Hardware7253/Koca58/README.md

# Lily58 Koca

A [Lily58](https://github.com/kata0510/Lily58) variant featuring SMT components, RJ45 interconnect and STM32F103 MCU.

## Pictures
Keyboard
Right Keyboard
Electronics Window
Connectors
