Hardware7253/Koca58/Case/Old/README.md

These are the old case files for the TRRS version of this design
