Hardware7253/Koca58/Case/Assembly.step

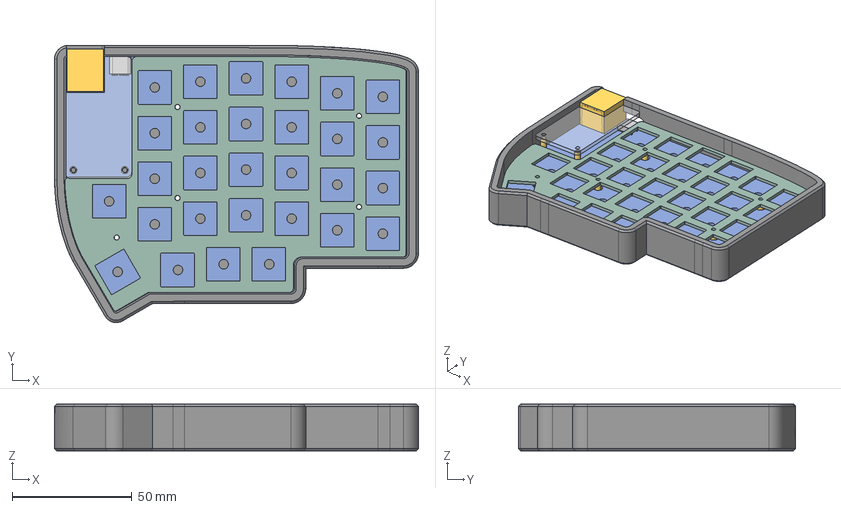
[picture p1: CAD file, 2025-12-16]
Case/Assembly.step
152.0 x 115.7 x 19.6 mm
Plate_PCB
Mount Standoff x 5
Assembly PCB
Right Case
Acrylic Standoff x 2
HRO TYPE-C-31-M-12
Acrylic Piece
54602-908LFc
