Hardware7253/Koca58/Case/Right Case.stl

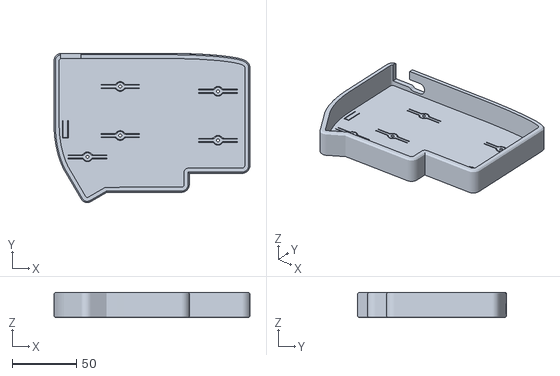
[picture p2: CAD file, 2025-12-16]
Case/Right Case.stl
152.0 x 115.7 x 19.6
