Hardware7253/Koca58/PCB/Koca.step

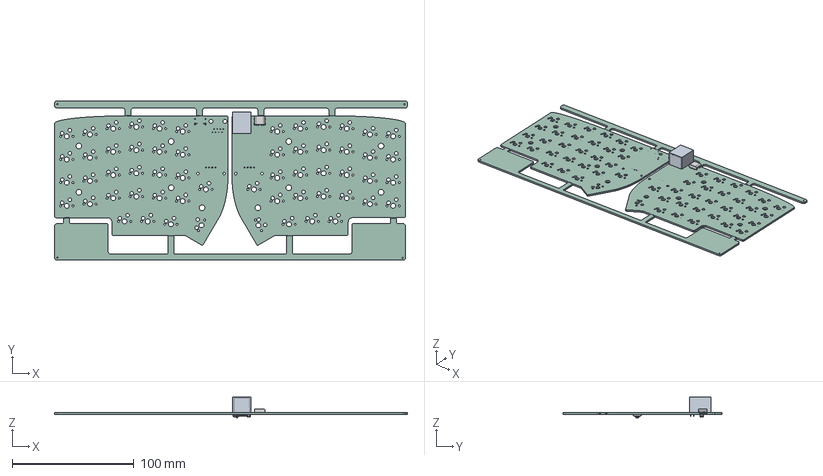
[picture p3: CAD file, 2025-05-18]
PCB/Koca.step
290.1 x 131.0 x 16.9 mm
54602-908LFc
HRO TYPE-C-31-M-12
SW_SPST_CK_RS282G05A3
Koca58_PCB
