Hardware7253/Koca58/Case/Old/Old Case.step

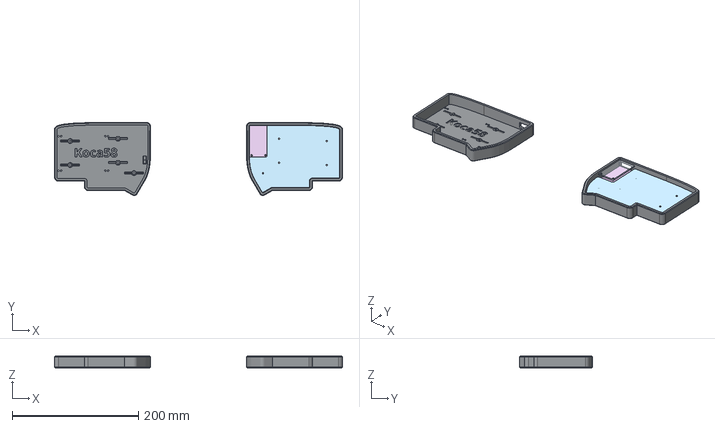
[picture p4: CAD file, 2025-05-18, an earlier design]
Case/Old/Old Case.step
456.3 x 115.7 x 18.6 mm
