Hardware7253/Koca58/(list of files, cad)

Other CAD files:
Case/Left Case.stl
