Hardware7253/Koca58/PCB/Koca58.kicad_pcb

## KiCad design PCB/Koca58.kicad_pcb (2026-08-27)

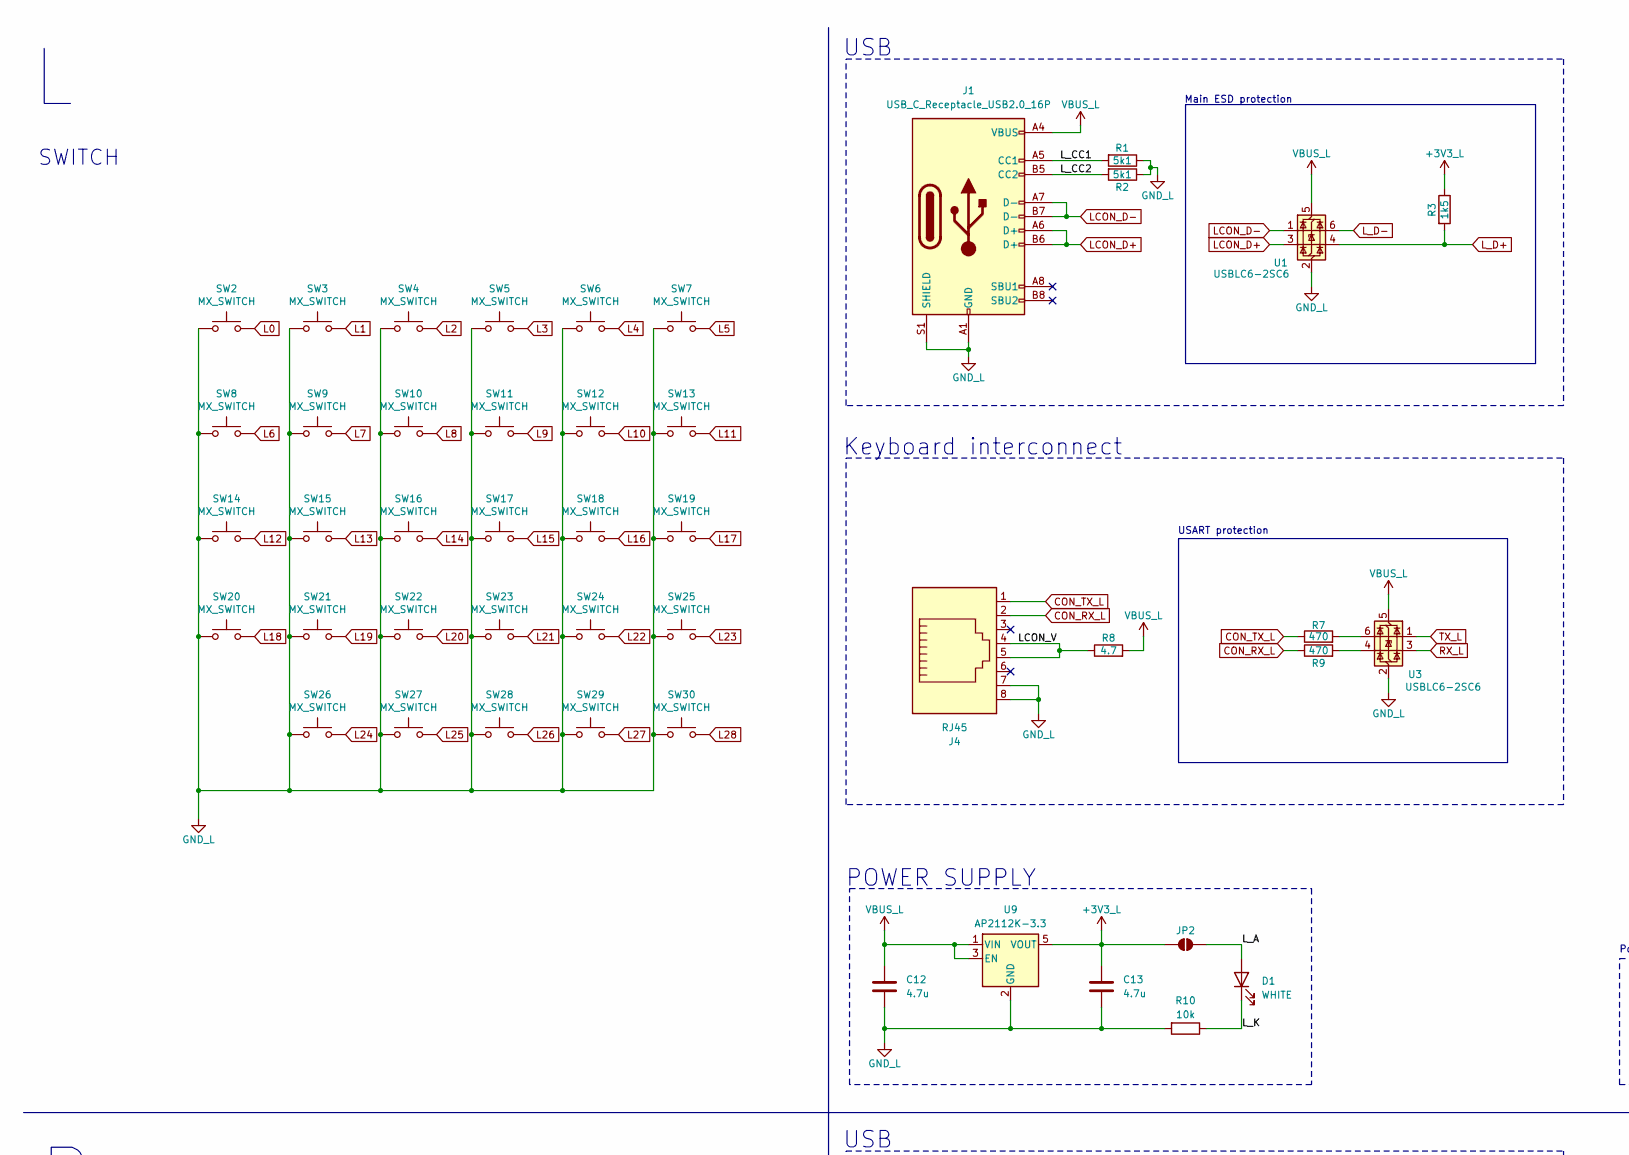
[picture p5: schematic Koca58.kicad_sch, part in row 1, column 1]

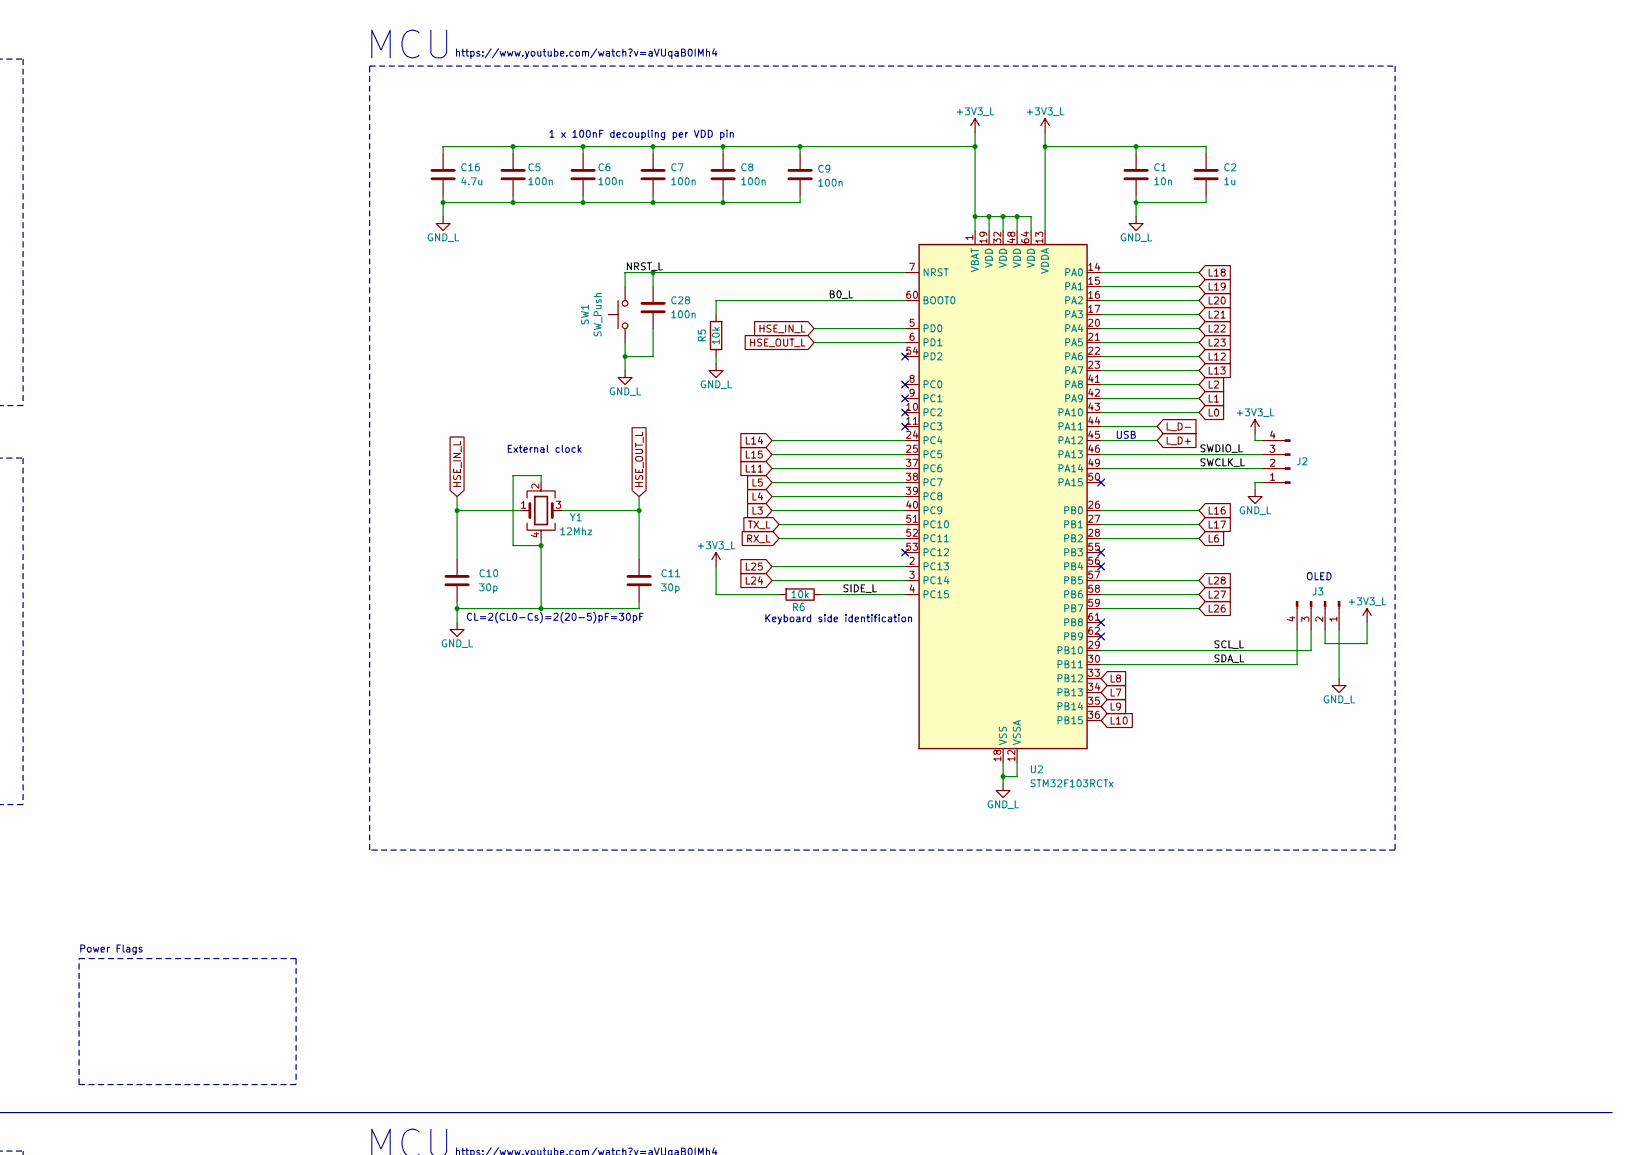
[picture p6: schematic Koca58.kicad_sch, part in row 1, column 2]

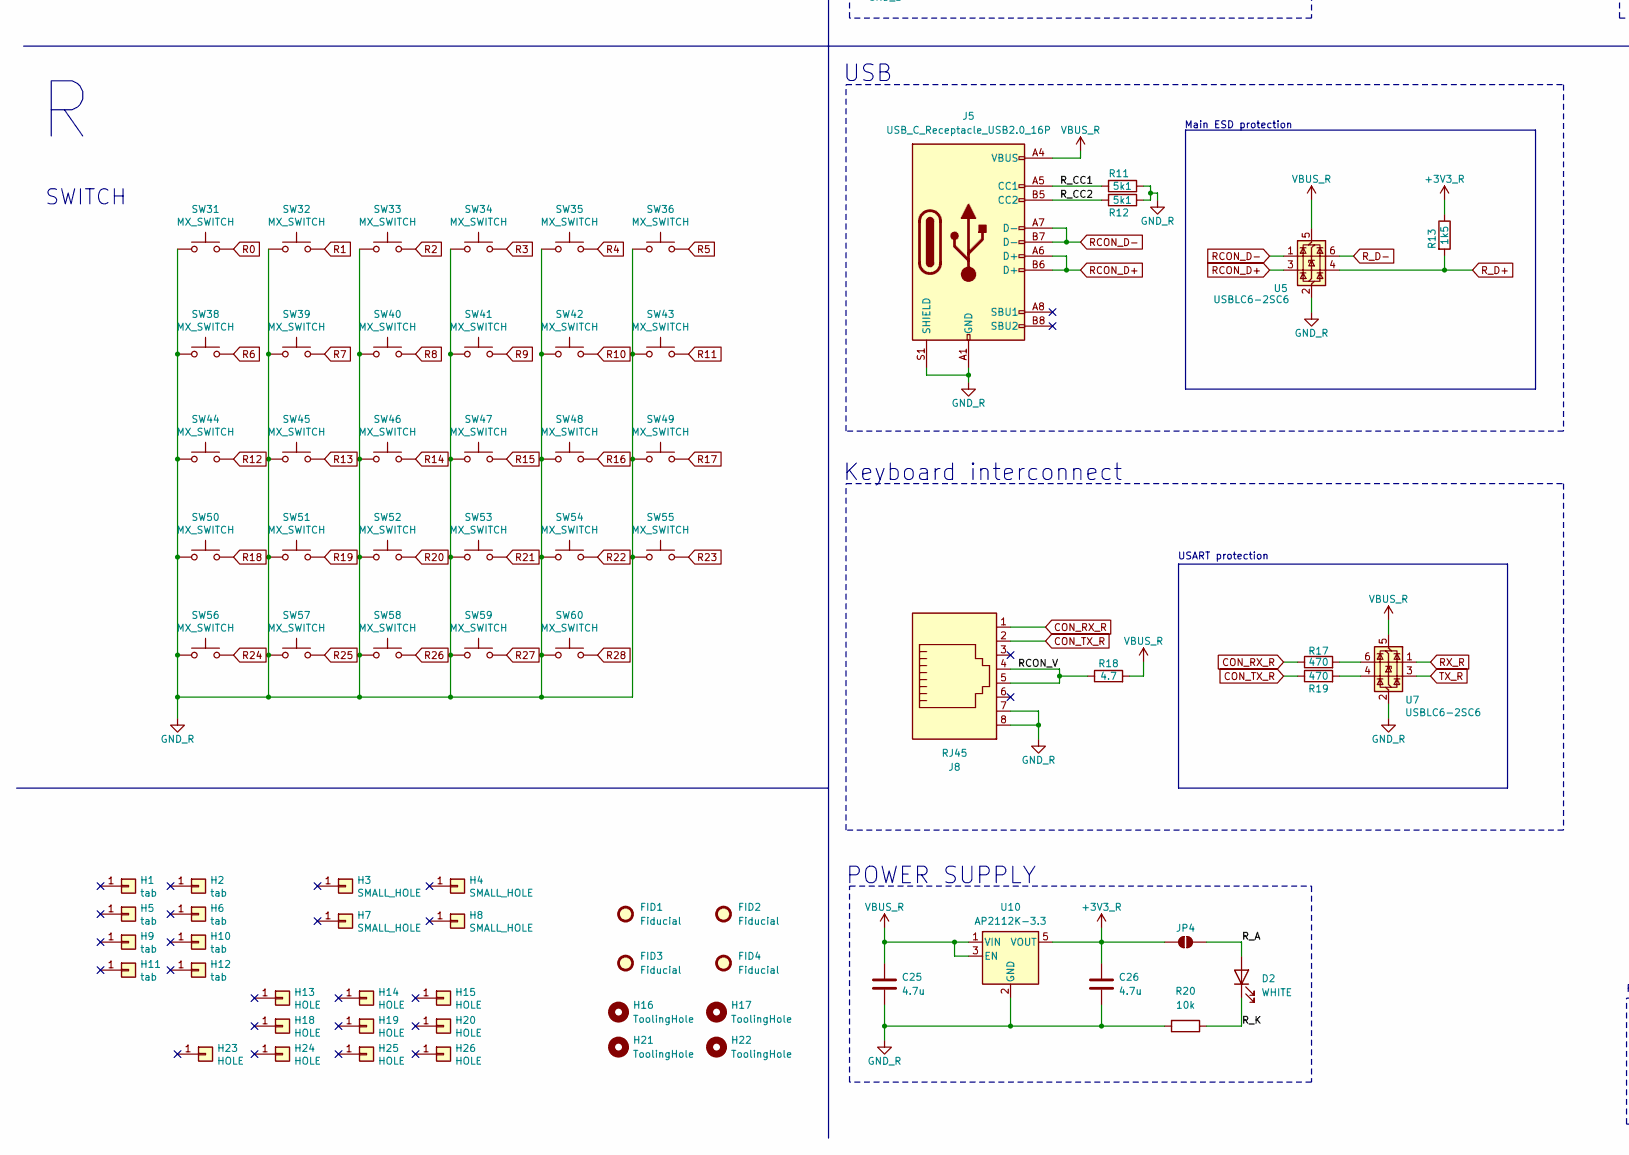
[picture p7: schematic Koca58.kicad_sch, part in row 2, column 1]

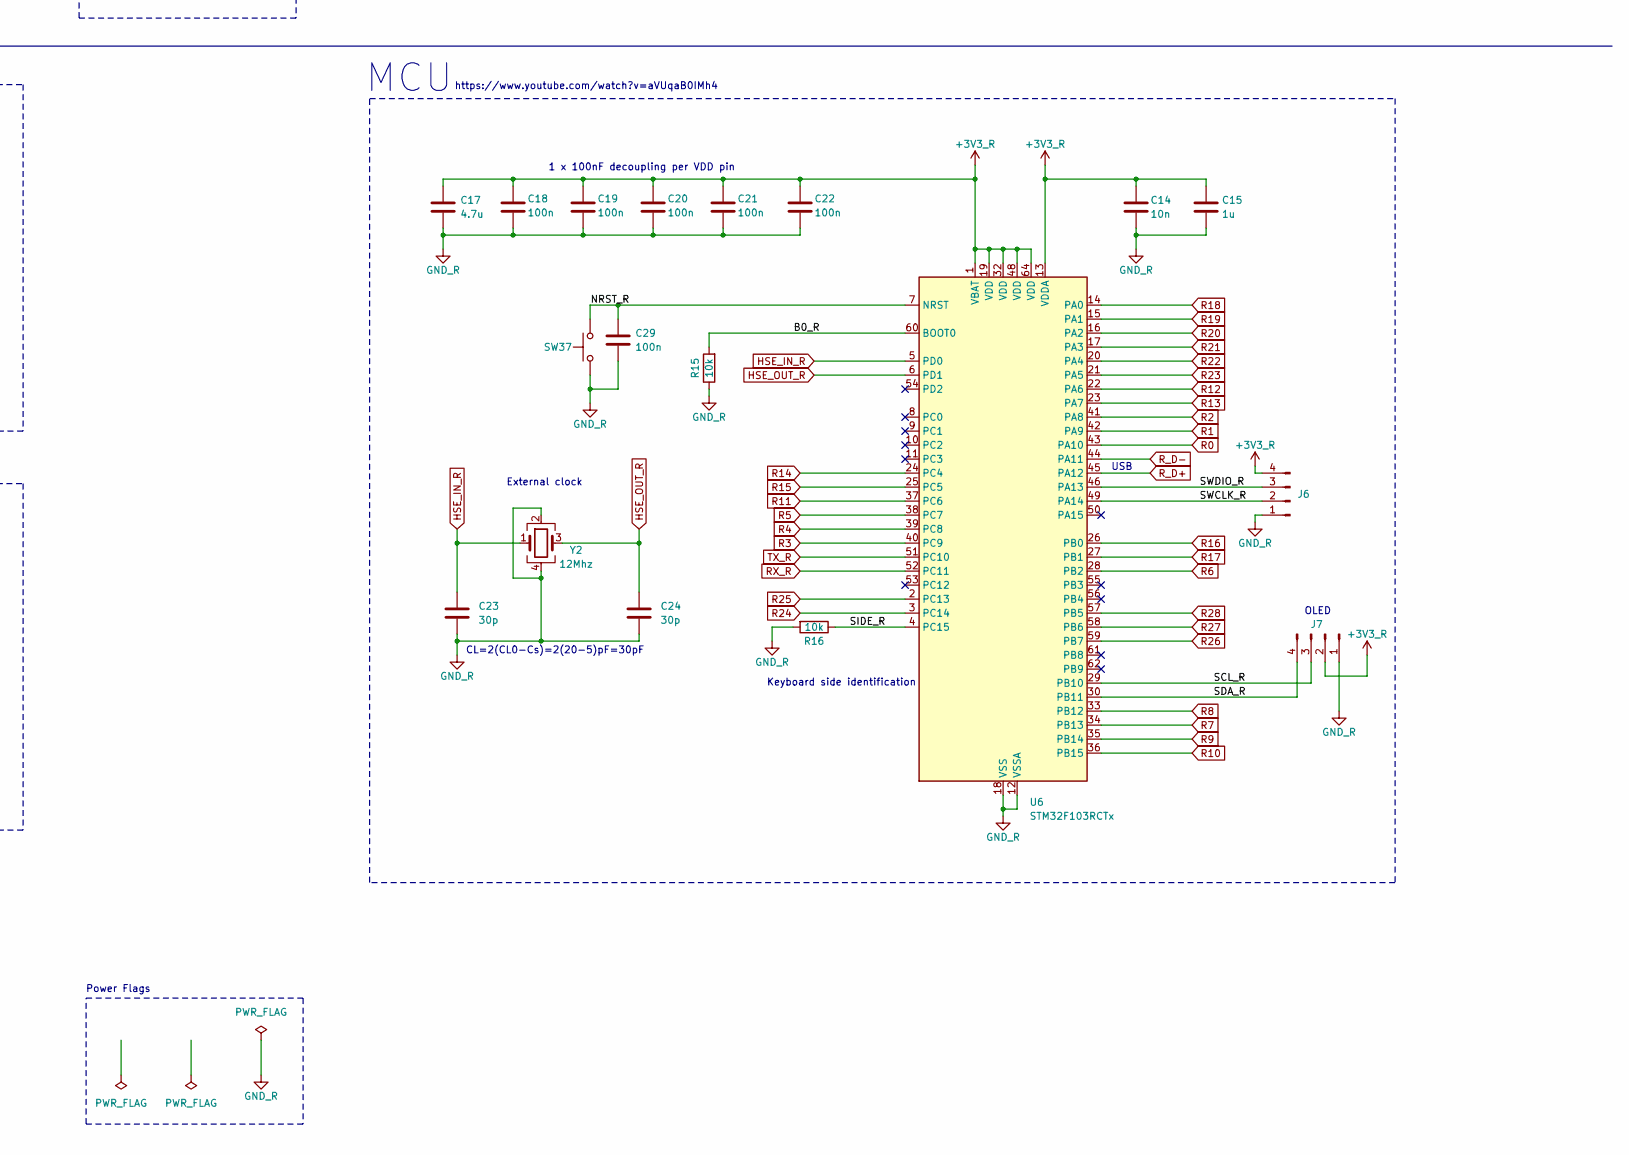
[picture p8: schematic Koca58.kicad_sch, part in row 2, column 2]

Parts:
C1, C14: 10n; C_0402_1005Metric; Manufacturer Part Number CL05B103KB5NNNC; LCSC/JLC Part Number C15195
C2, C15: 1u; C_0402_1005Metric; Manufacturer Part Number CL05A105KA5NQNC; LCSC/JLC Part Number C52923
C5, C6, C7, C8, C9, C18, C19, C20, C21, C22, C28, C29: 100n; C_0402_1005Metric; Manufacturer Part Number CL05B104KO5NNNC; LCSC/JLC Part Number C1525
C10, C11, C23, C24: 30p; C_0402_1005Metric; Manufacturer Part Number 0402CG330J500NT; LCSC/JLC Part Number C1562
C12, C13, C16, C17, C25, C26: 4.7u; C_0603_1608Metric; Manufacturer Part Number CL10A475KO8NNNC; LCSC/JLC Part Number C19666
D1, D2: WHITE; LED_0603_1608Metric; Manufacturer Part Number KT-0603W; LCSC/JLC Part Number C2290
FID1, FID2, FID3, FID4: Fiducial; Fiducial_1mm_Mask2mm
H1, H2, H5, H6, H9, H10, H11, H12: tab; MouseBite
H3, H4, H7, H8: SMALL_HOLE; MountingHole_2.2mm_M2_Pad
H13, H14, H15, H18, H19, H20, H23, H24, H25, H26: HOLE; Standoff_Hole
H16, H17, H21, H22: ToolingHole; SMD_Tooling_Hole
J1, J5: USB_C_Receptacle_USB2.0_16P; USB_TYPE-C-31-M-12; Manufacturer Part Number TYPE-C-31-M-12; LCSC/JLC Part Number C165948
J2, J6: Conn_01x04_Pin; SWD_POGO_P1.27
J3, J7: Conn_01x04_Pin; PinHeader_1x04_P2.54mm_Vertical
J4, J8: RJ45; RJ45_Amphenol_54602-x08_Horizontal; Manufacturer Part Number 54602-908LF; LCSC/JLC Part Number C2847314
JP2, JP4: SolderJumper_2_Open; SolderJumper-2_P1.3mm_Bridged_Pad1.0x1.5mm
R1, R2, R11, R12: 5k1; R_0402_1005Metric; Manufacturer Part Number 0402WGF5101TCE; LCSC/JLC Part Number C25905
R3, R13: 1k5; R_0402_1005Metric; Manufacturer Part Number 0402WGF1501TCE; LCSC/JLC Part Number C25867
R5, R6, R10, R15, R16, R20: 10k; R_0402_1005Metric; Manufacturer Part Number 0402WGF1002TCE; LCSC/JLC Part Number C25744
R7, R9, R17, R19: 470; R_0402_1005Metric; Manufacturer Part Number 0402WGF4700TCE; LCSC/JLC Part Number C25117
R8, R18: 4.7; R_0603_1608Metric; Manufacturer Part Number 0603WAF470KT5E; LCSC/JLC Part Number C23164
SW1, SW37: SW_Push; Korean Hroparts Elec K2-1107ST-A4DW-06; Manufacturer Part Number K2-1107ST-A4DW-06; LCSC/JLC Part Number C118141
SW2, SW3, SW4, SW5, SW6, SW7, SW8, SW9, SW10, SW11, SW12, SW13, SW14, SW15, SW16, SW17, SW18, SW19, SW20, SW21, SW22, SW23, SW24, SW25, SW26, SW27, SW28, SW29, SW30, SW31, SW32, SW33, SW34, SW35, SW36, SW38, SW39, SW40, SW41, SW42, SW43, SW44, SW45, SW46, SW47, SW48, SW49, SW50, SW51, SW52, SW53, SW54, SW55, SW56, SW57, SW58, SW59, SW60: MX_SWITCH; MX_Hotswap; Manufacturer Part Number CPG151101S11-16; LCSC/JLC Part Number C41430893
U1, U3, U5, U7: USBLC6-2SC6; SOT-23-6; Manufacturer Part Number USBLC6-2SC6; LCSC/JLC Part Number C2687116
U2, U6: STM32F103RCTx; LQFP-64_10x10mm_P0.5mm; Manufacturer Part Number STM32F103RCT6; LCSC/JLC Part Number C8323
U9, U10: AP2112K-3.3; SOT-23-5; Manufacturer Part Number AP2112K-3.3TRG1; LCSC/JLC Part Number C51118
Y1, Y2: 12Mhz; Crystal_SMD_3225-4Pin_3.2x2.5mm; Manufacturer Part Number X322512MSB4SI; LCSC/JLC Part Number C9002

Connections:
+3V3_L: C1.1, C2.1, C5.1, C6.1, C7.1, C8.1, C9.1, C13.1, C16.1, J2.4, J3.2, JP2.1 (A), R3.1, R6.2, U2.1 (VBAT), U2.13 (VDDA), U2.19 (VDD), U2.32 (VDD), U2.48 (VDD), U2.64 (VDD), U9.5 (VOUT)
+3V3_R: C14.1, C15.1, C17.1, C18.1, C19.1, C20.1, C21.1, C22.1, C26.1, J6.4, J7.2, JP4.1 (A), R13.1, U6.1 (VBAT), U6.13 (VDDA), U6.19 (VDD), U6.32 (VDD), U6.48 (VDD), U6.64 (VDD), U10.5 (VOUT)
/B0_L: R5.2, U2.60 (BOOT0)
/B0_R: R15.2, U6.60 (BOOT0)
/LCON_V: J4.4, J4.5, R8.1
/L_A: D1.2 (A), JP2.2 (B)
/L_CC1: J1.A5 (CC1), R1.2
/L_CC2: J1.B5 (CC2), R2.2
/L_K: D1.1 (K), R10.1
/NRST_L: C28.1, SW1.2, U2.7 (NRST)
/NRST_R: C29.1, SW37.2, U6.7 (NRST)
/RCON_V: J8.4, J8.5, R18.1
/R_A: D2.2 (A), JP4.2 (B)
/R_CC1: J5.A5 (CC1), R11.2
/R_CC2: J5.B5 (CC2), R12.2
/R_K: D2.1 (K), R20.1
/SCL_L: J3.3, U2.29 (PB10)
/SCL_R: J7.3, U6.29 (PB10)
/SDA_L: J3.4, U2.30 (PB11)
/SDA_R: J7.4, U6.30 (PB11)
/SIDE_L: R6.1, U2.4 (PC15)
/SIDE_R: R16.1, U6.4 (PC15)
/SWCLK_L: J2.2, U2.49 (PA14)
/SWCLK_R: J6.2, U6.49 (PA14)
/SWDIO_L: J2.3, U2.46 (PA13)
/SWDIO_R: J6.3, U6.46 (PA13)
CON_RX_L: J4.2, R9.1
CON_RX_R: J8.1, R17.1
CON_TX_L: J4.1, R7.1
CON_TX_R: J8.2, R19.1
GND_L: C1.2, C2.2, C5.2, C6.2, C7.2, C8.2, C9.2, C10.2, C11.2, C12.2, C13.2, C16.2, C28.2, J1.A1 (GND), J1.A12 (GND), J1.B1 (GND), J1.B12 (GND), J1.S1 (SHIELD), J2.1, J3.1, J4.7, J4.8, R1.1, R2.1, R5.1, R10.2, SW1.1, SW2.1, SW3.1, SW4.1, SW5.1, SW6.1, SW7.1, SW8.1, SW9.1, SW10.1, SW11.1, SW12.1, SW13.1, SW14.1, SW15.1, SW16.1, SW17.1, SW18.1, SW19.1, SW20.1, SW21.1, SW22.1, SW23.1, SW24.1, SW25.1, SW26.1, SW27.1, SW28.1, SW29.1, SW30.1, U1.2 (GND), U2.12 (VSSA), U2.18 (VSS), U2.31 (VSS), U2.47 (VSS), U2.63 (VSS), U3.2 (GND), U9.2 (GND), Y1.2, Y1.4
GND_R: C14.2, C15.2, C17.2, C18.2, C19.2, C20.2, C21.2, C22.2, C23.2, C24.2, C25.2, C26.2, C29.2, J5.A1 (GND), J5.A12 (GND), J5.B1 (GND), J5.B12 (GND), J5.S1 (SHIELD), J6.1, J7.1, J8.7, J8.8, R11.1, R12.1, R15.1, R16.2, R20.2, SW31.1, SW32.1, SW33.1, SW34.1, SW35.1, SW36.1, SW37.1, SW38.1, SW39.1, SW40.1, SW41.1, SW42.1, SW43.1, SW44.1, SW45.1, SW46.1, SW47.1, SW48.1, SW49.1, SW50.1, SW51.1, SW52.1, SW53.1, SW54.1, SW55.1, SW56.1, SW57.1, SW58.1, SW59.1, SW60.1, U5.2 (GND), U6.12 (VSSA), U6.18 (VSS), U6.31 (VSS), U6.47 (VSS), U6.63 (VSS), U7.2 (GND), U10.2 (GND), Y2.2, Y2.4
HSE_IN_L: C10.1, U2.5 (PD0), Y1.1
HSE_IN_R: C23.1, U6.5 (PD0), Y2.1
HSE_OUT_L: C11.1, U2.6 (PD1), Y1.3
HSE_OUT_R: C24.1, U6.6 (PD1), Y2.3
L0: SW2.2, U2.43 (PA10)
L1: SW3.2, U2.42 (PA9)
L2: SW4.2, U2.41 (PA8)
L3: SW5.2, U2.40 (PC9)
L4: SW6.2, U2.39 (PC8)
L5: SW7.2, U2.38 (PC7)
L6: SW8.2, U2.28 (PB2)
L7: SW9.2, U2.34 (PB13)
L8: SW10.2, U2.33 (PB12)
L9: SW11.2, U2.35 (PB14)
L10: SW12.2, U2.36 (PB15)
L11: SW13.2, U2.37 (PC6)
L12: SW14.2, U2.22 (PA6)
L13: SW15.2, U2.23 (PA7)
L14: SW16.2, U2.24 (PC4)
L15: SW17.2, U2.25 (PC5)
L16: SW18.2, U2.26 (PB0)
L17: SW19.2, U2.27 (PB1)
L18: SW20.2, U2.14 (PA0)
L19: SW21.2, U2.15 (PA1)
L20: SW22.2, U2.16 (PA2)
L21: SW23.2, U2.17 (PA3)
L22: SW24.2, U2.20 (PA4)
L23: SW25.2, U2.21 (PA5)
L24: SW26.2, U2.3 (PC14)
L25: SW27.2, U2.2 (PC13)
L26: SW28.2, U2.59 (PB7)
L27: SW29.2, U2.58 (PB6)
L28: SW30.2, U2.57 (PB5)
LCON_D+: J1.A6 (D+), J1.B6 (D+), U1.3 (I/O2)
LCON_D-: J1.A7 (D-), J1.B7 (D-), U1.1 (I/O1)
L_D+: R3.2, U1.4 (I/O2), U2.45 (PA12)
L_D-: U1.6 (I/O1), U2.44 (PA11)
unnamed: R7.2, U3.6 (I/O1)
unnamed: R9.2, U3.4 (I/O2)
unnamed: R17.2, U7.6 (I/O1)
unnamed: R19.2, U7.4 (I/O2)
R0: SW31.2, U6.43 (PA10)
R1: SW32.2, U6.42 (PA9)
R2: SW33.2, U6.41 (PA8)
R3: SW34.2, U6.40 (PC9)
R4: SW35.2, U6.39 (PC8)
R5: SW36.2, U6.38 (PC7)
R6: SW38.2, U6.28 (PB2)
R7: SW39.2, U6.34 (PB13)
R8: SW40.2, U6.33 (PB12)
R9: SW41.2, U6.35 (PB14)
R10: SW42.2, U6.36 (PB15)
R11: SW43.2, U6.37 (PC6)
R12: SW44.2, U6.22 (PA6)
R13: SW45.2, U6.23 (PA7)
R14: SW46.2, U6.24 (PC4)
R15: SW47.2, U6.25 (PC5)
R16: SW48.2, U6.26 (PB0)
R17: SW49.2, U6.27 (PB1)
R18: SW50.2, U6.14 (PA0)
R19: SW51.2, U6.15 (PA1)
R20: SW52.2, U6.16 (PA2)
R21: SW53.2, U6.17 (PA3)
R22: SW54.2, U6.20 (PA4)
R23: SW55.2, U6.21 (PA5)
R24: SW56.2, U6.3 (PC14)
R25: SW57.2, U6.2 (PC13)
R26: SW58.2, U6.59 (PB7)
R27: SW59.2, U6.58 (PB6)
R28: SW60.2, U6.57 (PB5)
RCON_D+: J5.A6 (D+), J5.B6 (D+), U5.3 (I/O2)
RCON_D-: J5.A7 (D-), J5.B7 (D-), U5.1 (I/O1)
RX_L: U2.52 (PC11), U3.3 (I/O2)
RX_R: U6.52 (PC11), U7.1 (I/O1)
R_D+: R13.2, U5.4 (I/O2), U6.45 (PA12)
R_D-: U5.6 (I/O1), U6.44 (PA11)
TX_L: U2.51 (PC10), U3.1 (I/O1)
TX_R: U6.51 (PC10), U7.3 (I/O2)
VBUS_L: C12.1, J1.A4 (VBUS), J1.A9 (VBUS), J1.B4 (VBUS), J1.B9 (VBUS), R8.2, U1.5 (VBUS), U3.5 (VBUS), U9.1 (VIN), U9.3 (EN)
VBUS_R: C25.1, J5.A4 (VBUS), J5.A9 (VBUS), J5.B4 (VBUS), J5.B9 (VBUS), R18.2, U5.5 (VBUS), U7.5 (VBUS), U10.1 (VIN), U10.3 (EN)

Notes on the sheet:
1 x 100nF decoupling per VDD pin
USART protection
Keyboard interconnect
SWITCH
USB
CL=2(CL0-Cs)=2(20-5)pF=30pF
Main ESD protection
MCU
POWER SUPPLY
https://www.youtube.com/watch?v=aVUqaB0IMh4
OLED
Keyboard side identification
External clock
Power Flags

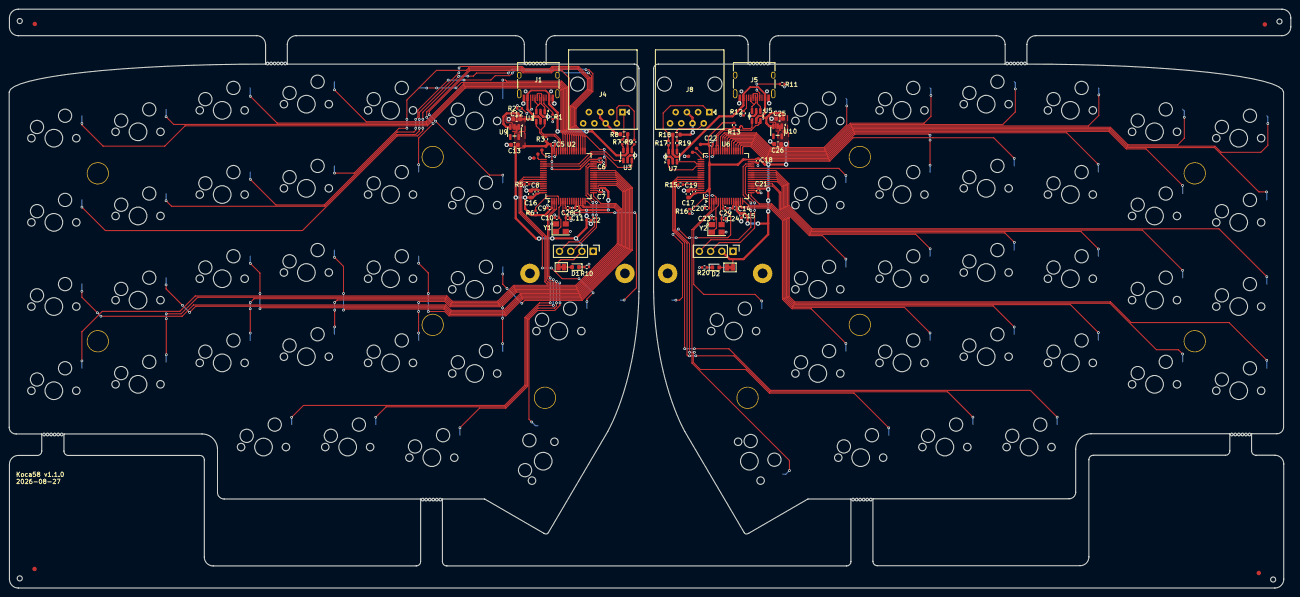
[picture p9: board Koca58.kicad_pcb from above]

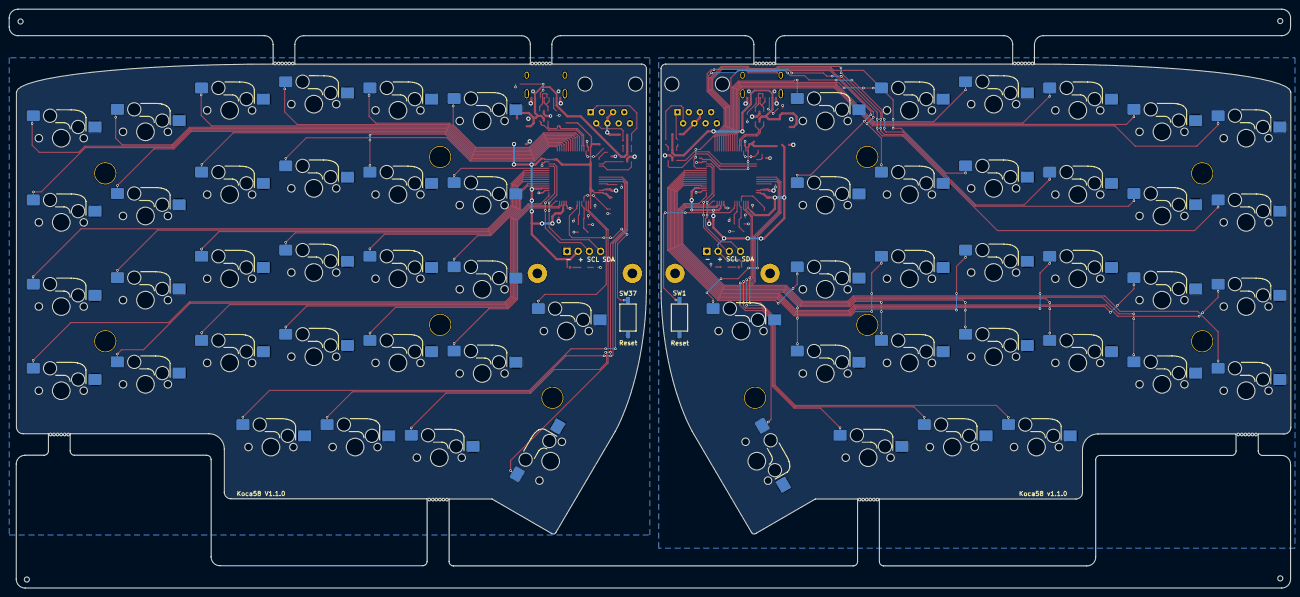
[picture p10: board Koca58.kicad_pcb from below]

Board: 2 copper layers, 290.1 x 131.0 mm, 156 parts (60 on the bottom side), 112 nets.
