Hardware7253/Koca58/(commit log)

2025-01-21 First real commit
    Add KiCad design files and bootloader binary
    [Koca-B_Cu.gbl, Koca-B_Mask.gbs, Koca-B_Paste.gbp, Koca-B_Silkscreen.gbo, Koca-Edge_Cuts.gm1, Koca-F_Cu.gtl, Koca-F_Mask.gts, Koca-F_Paste.gtp]
2025-01-29 switch to direct matrix
    [KOCA_BOM_PCBX.csv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]
2025-02-19 Prepared files for double sided PCBA
    [KOCA_BOM_PCBX.csv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]
2025-02-28 Fixed PCBx BOM
    PCBx BOM listed the wrong crystal oscillator
    [KOCA_BOM_PCBX.csv]
2025-03-07 Improve via spacing
    [KOCA_POS.csv, Koca-B_Cu.gbl, Koca-B_Mask.gbs, Koca-B_Paste.gbp, Koca-B_Silkscreen.gbo, Koca-Edge_Cuts.gm1, Koca-F_Cu.gtl, Koca-F_Mask.gts]
2025-04-14 Bout to imrpove hotplug protection
    Making a commit now because I have some new changes and I want something
    to fall back on if the new design changes suck.
    [Koca-B_Cu.gbl, Koca-B_Mask.gbs, Koca-B_Paste.gbp, Koca-B_Silkscreen.gbo, Koca-Edge_Cuts.gm1, Koca-F_Cu.gtl, Koca-F_Mask.gts, Koca-F_Paste.gtp]
2025-04-15 Added hotplugging protection to TRRS
    Technically added hotplugging protection. But it won't work because
    current isn't able to flow both directions in this design. It would
    require one side to always be the slave. But the hotplug protection for
    the master would then suck. So I'm about to try switch to USB-C for the
    interconnect.
    [Koca.kicad_sch]
2025-04-29 Switch to RJ45 Interconnects
    [Koca.kicad_sch]
2025-05-10 Renamed project
    Renamed project to Koca58 because it's now quite different to the
    Lily58. Also added fields to parts within KiCad so the python BOM
    generator could be removed.
    [KOCA_BOM_PCBX.csv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]
2025-05-18 Added new case files
    Also did some minor changes to the main PCB
    [Case.step, Koca.step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]
2025-05-27 Improved via to pad spacing
    Fab complained
    [Koca58-B_Cu.gbl, Koca58-B_Mask.gbs, Koca58-B_Paste.gbp, Koca58-B_Silkscreen.gbo, Koca58-Edge_Cuts.gm1, Koca58-F_Cu.gtl, Koca58-F_Mask.gts, Koca58-F_Paste.gtp]
2025-12-16 Updated case
    [Assembly.step, Case.step, Left Case.stl, Right Case.stl]
2026-08-27 Re-routed PCB
    Both keyboard sides were completely rerouted so
    that all components are on the top-side (except for hotswap sockets).
    Also reduced BOM slightly and switched to a better linear regulator.
    This change also reduced the total VBUS capacitance to under 10uF,
    making the device properly meet the USB-C spec.
    USB-C differential pairs also have 90 ohm differential impedance now,
    and have matched lengths. Trace width and gap was calculated using
    JLCPCB controlled impedance calculator.
    [Koca58-B_Cu.gbl, Koca58-B_Mask.gbs, Koca58-B_Paste.gbp, Koca58-B_Silkscreen.gbo, Koca58-Edge_Cuts.gm1, Koca58-F_Cu.gtl, Koca58-F_Mask.gts, Koca58-F_Paste.gtp]
